julijanz/ArduTester-Bluetooth/ArduTester 1.04.005 Bluetooth.png

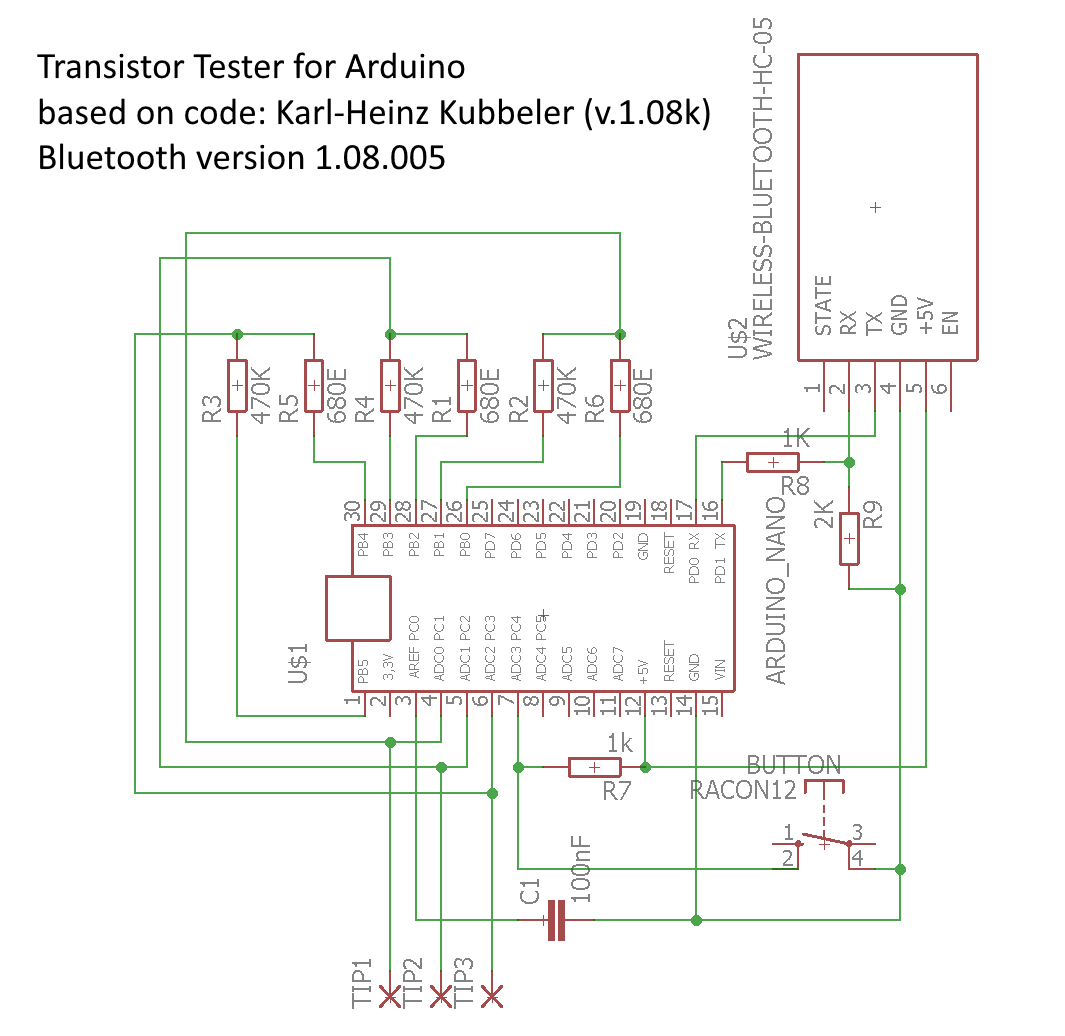
ArduTester 1.04.005 Bluetooth.png
