julijanz/ArduTester-Bluetooth/ArduTester.sch

## EAGLE design ArduTester.sch (2023-12-30)

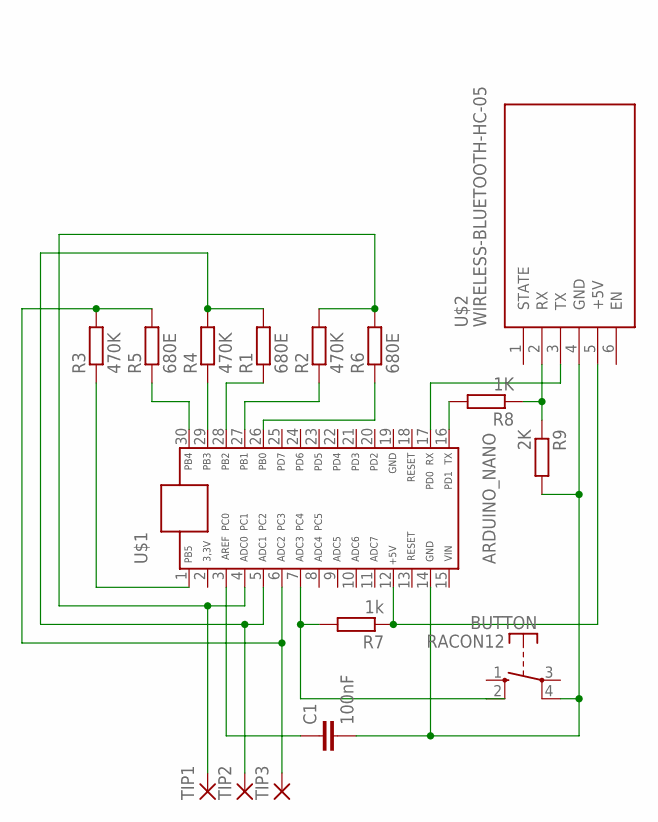
[picture p2: schematic ArduTester.sch]

Parts:
BUTTON: RACON12
C1: 100nF; C050-024X044
R1, R5, R6: 680E; 0204/7
R2, R3, R4: 470K; 0204/7
R7: 1k; 0204/7
R8: 1K; 0204/7
R9: 2K; 0204/7
TIP1, TIP2, TIP3: 2,54/0,9
U$1: ARDUINO_NANO
U$2: WIRELESS-BLUETOOTH-HC-05

Connections:
unnamed: R5.1, U$1.30
unnamed: R4.1, U$1.29
unnamed: R1.1, U$1.28
unnamed: R2.1, U$1.27
unnamed: R6.1, U$1.26
unnamed: R3.1, U$1.1
unnamed: R8.2, U$1.16
unnamed: BUTTON.4, C1.2, R9.2, U$1.14, U$2.4 (GND)
unnamed: R8.1, R9.1, U$2.2 (RX)
unnamed: R7.1, U$1.12, U$2.5 (+5V)
unnamed: C1.1, U$1.3
unnamed: BUTTON.2 (S), R7.2, U$1.7
unnamed: U$1.17, U$2.3 (TX)
unnamed: R1.2, R4.2, TIP2.1, U$1.5
unnamed: R3.2, R5.2, TIP3.1, U$1.6
unnamed: R2.2, R6.2, TIP1.1, U$1.4
