julijanz/ArduTester-Bluetooth/(notices)

Notices in the files:
parts and their libraries:
jzDiy-modules: Released under the Creative Commons Attribution 4.0 International License: http://creativecommons.org/licenses/by/4.0
